itzzhashtag/ClickClock/Example - (My Build)/Top View.jpeg

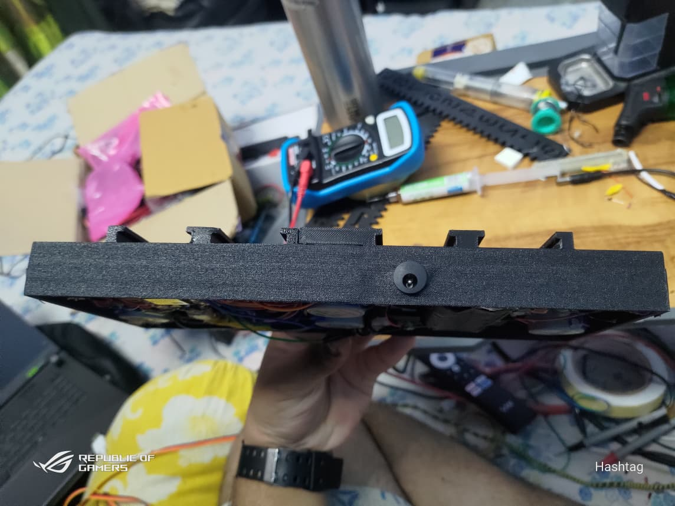
Example - (My Build)/Top View.jpeg
