itzzhashtag/ClickClock/Example - (My Build)/Back View 1.jpeg

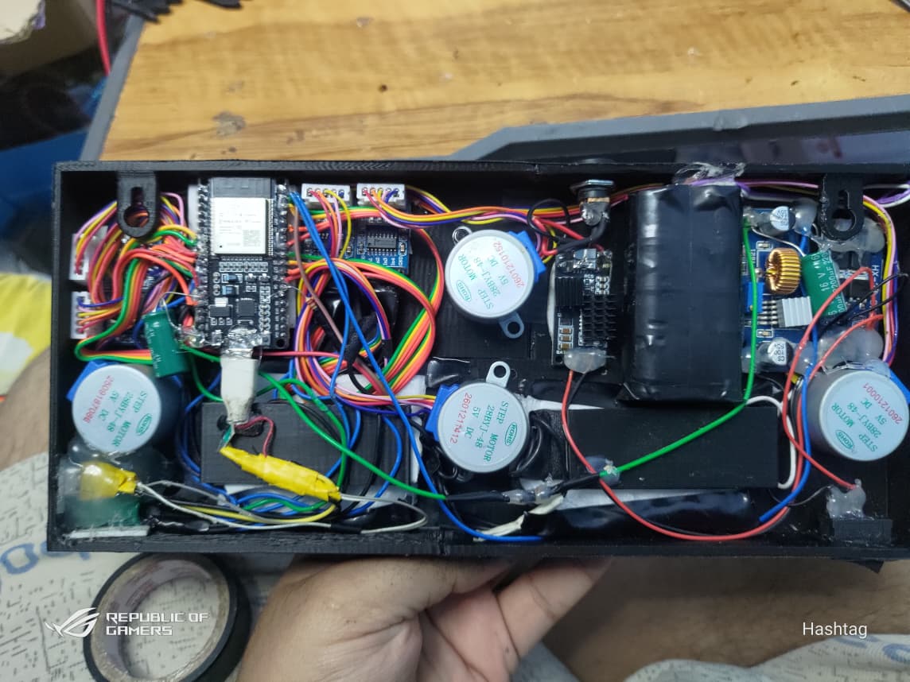
Example - (My Build)/Back View 1.jpeg
