itzzhashtag/ClickClock/STL files/FullDigit.stl

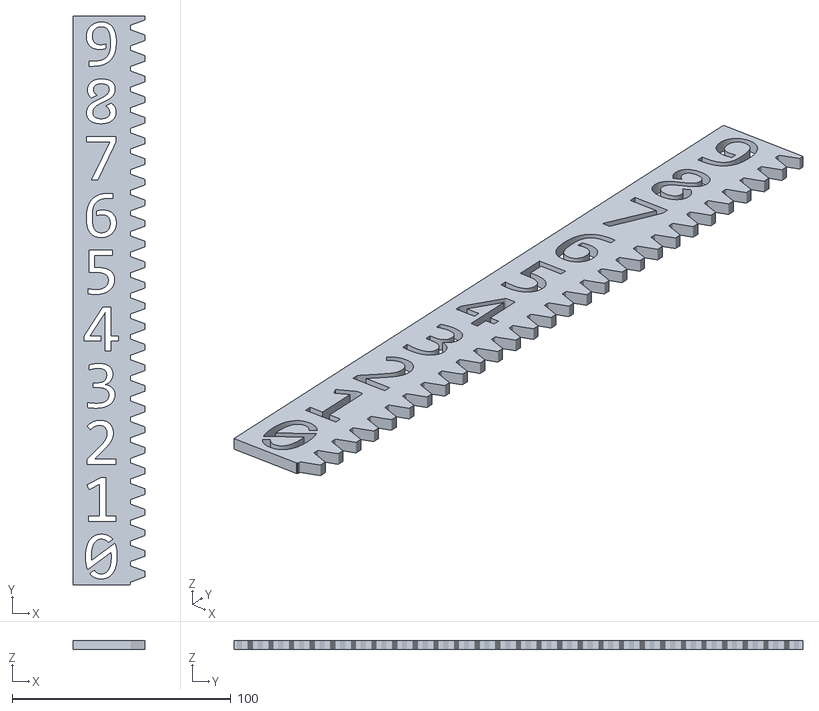
[picture p3: CAD file, 2026-03-24]
STL files/FullDigit.stl
33.0 x 260.0 x 4.00
