itzzhashtag/ClickClock/STL files/LightBrick.stl

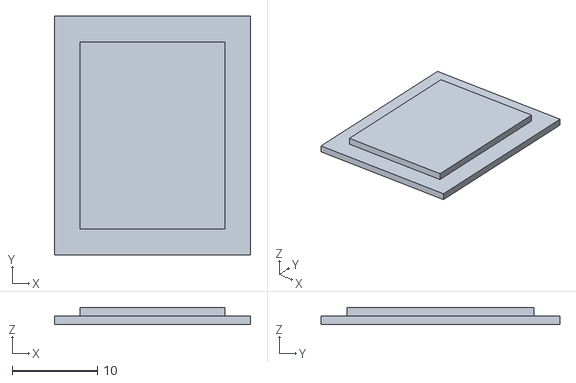
[picture p4: CAD file, 2026-03-24]
STL files/LightBrick.stl
23.0 x 28.0 x 2.00
