itzzhashtag/ClickClock/STL files/6Digit.stl

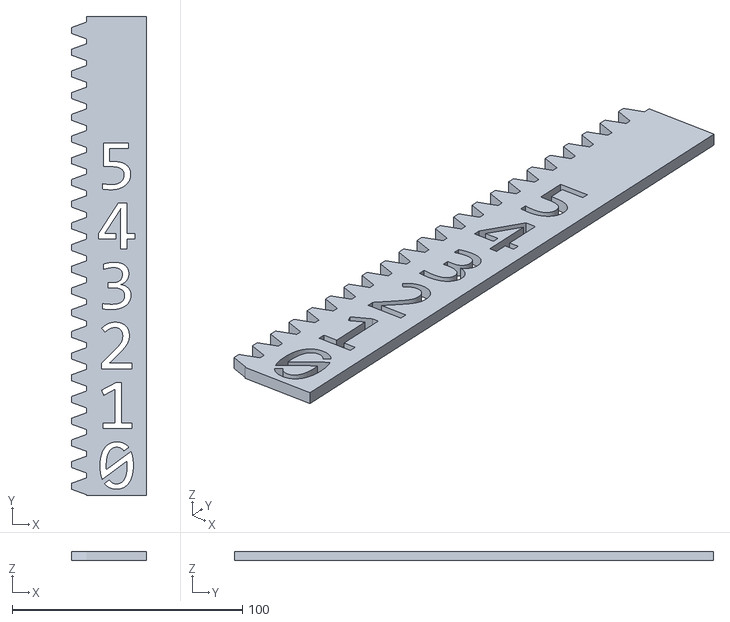
[picture p5: CAD file, 2026-03-24]
STL files/6Digit.stl
32.7 x 208.0 x 4.00
