itzzhashtag/ClickClock/STL files/BaseB.stl

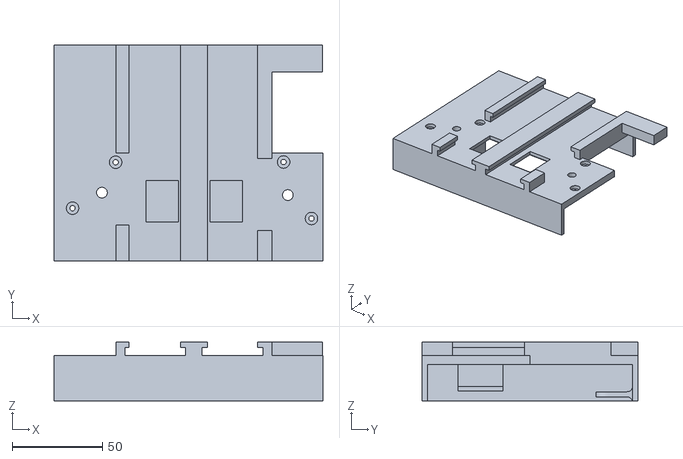
[picture p6: CAD file, 2026-03-24]
STL files/BaseB.stl
149.4 x 120.0 x 32.5
