itzzhashtag/ClickClock/STL files/3Digit.stl

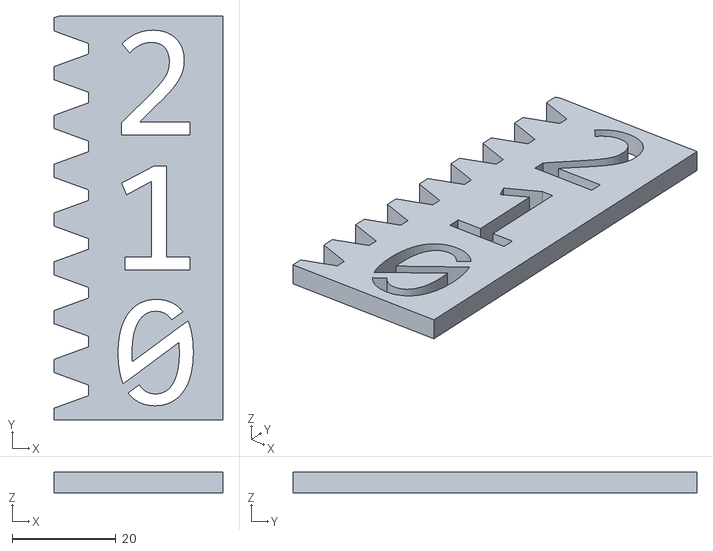
[picture p7: CAD file, 2026-03-24]
STL files/3Digit.stl
32.6 x 78.0 x 4.00
