itzzhashtag/ClickClock/STL files/Gear.stl

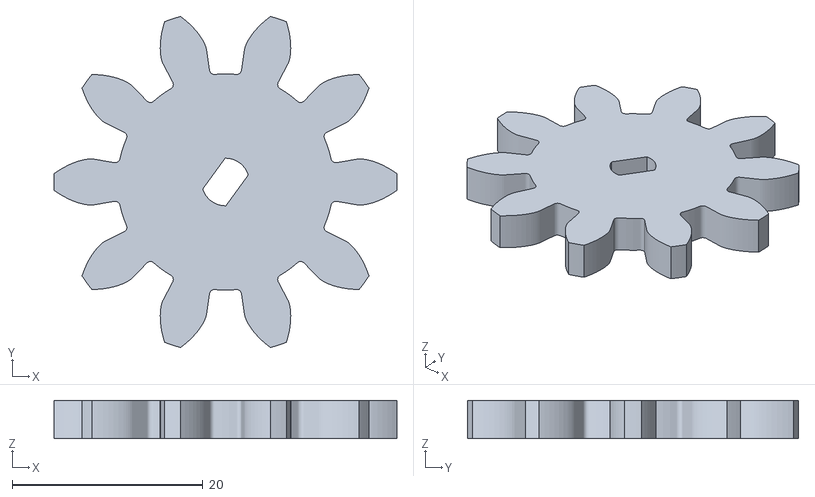
[picture p8: CAD file, 2026-03-24]
STL files/Gear.stl
36.0 x 34.7 x 4.00
