itzzhashtag/ClickClock/STL files/BaseA.stl

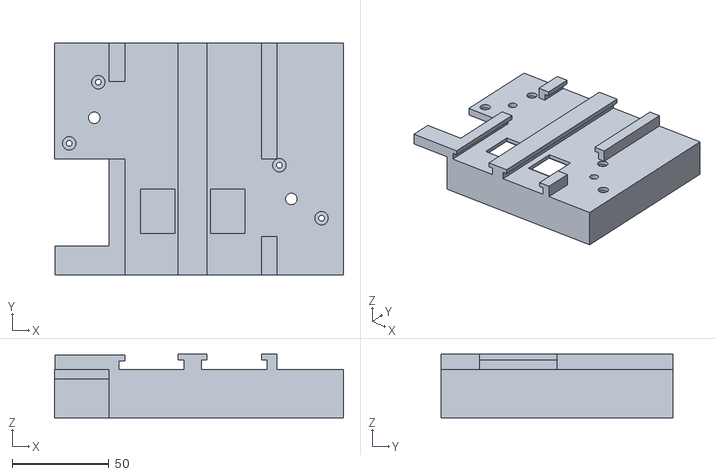
[picture p9: CAD file, 2026-03-24]
STL files/BaseA.stl
149.5 x 120.0 x 33.0
