itzzhashtag/ClickClock/Example - (My Build)/Back View 2.jpeg

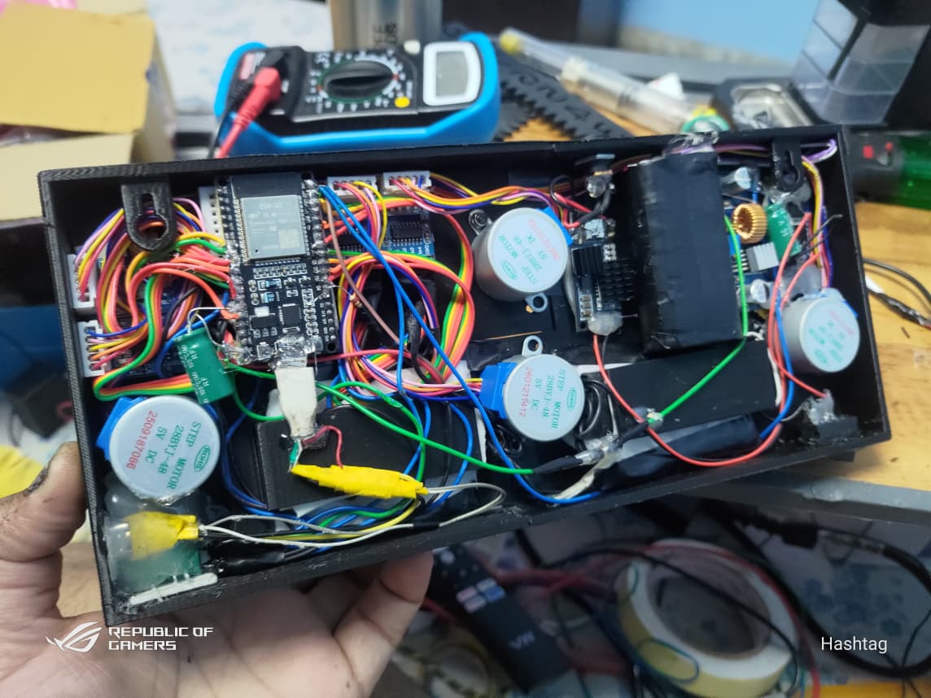
Example - (My Build)/Back View 2.jpeg
