itzzhashtag/ClickClock/Example - (My Build)/Bottom View.jpeg

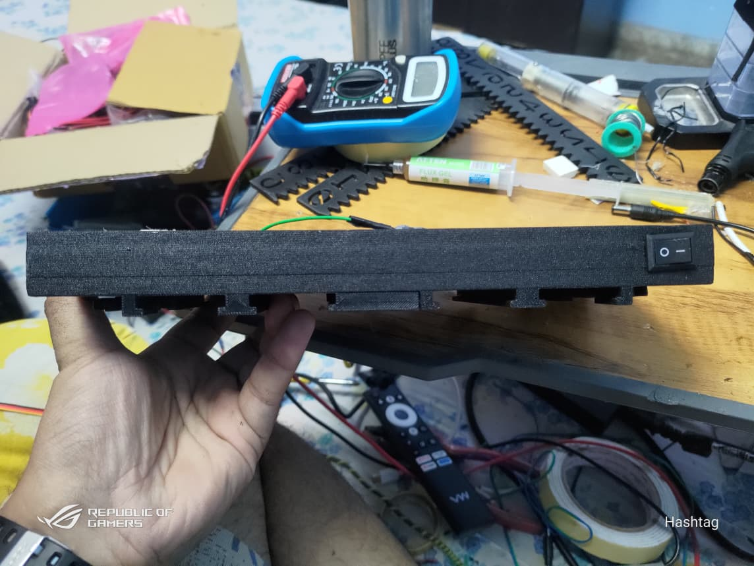
Example - (My Build)/Bottom View.jpeg
