itzzhashtag/ClickClock/Example - (My Build)/Front View.jpeg

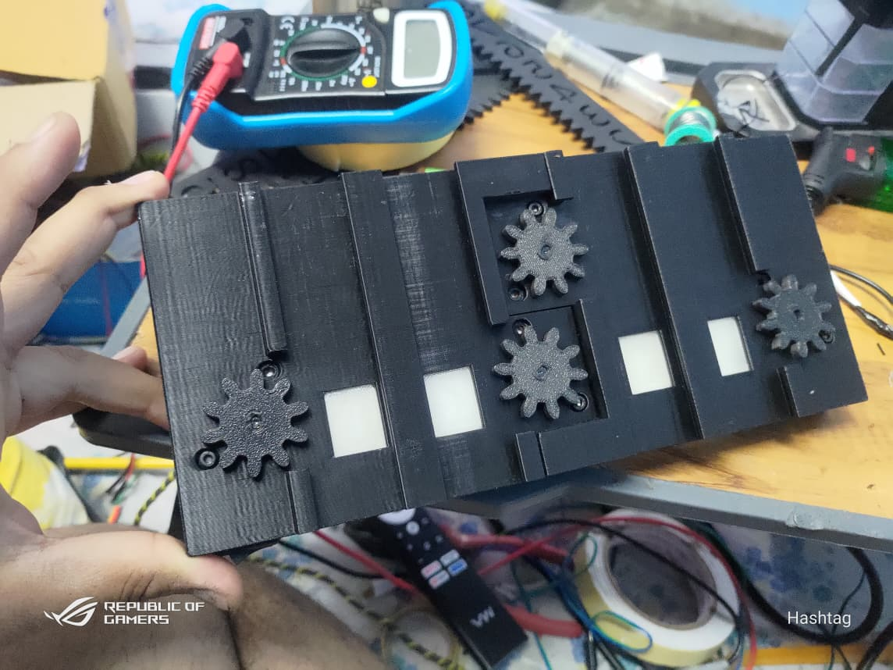
Example - (My Build)/Front View.jpeg
