itzzhashtag/ClickClock/Example - (My Build)/Left View.jpeg

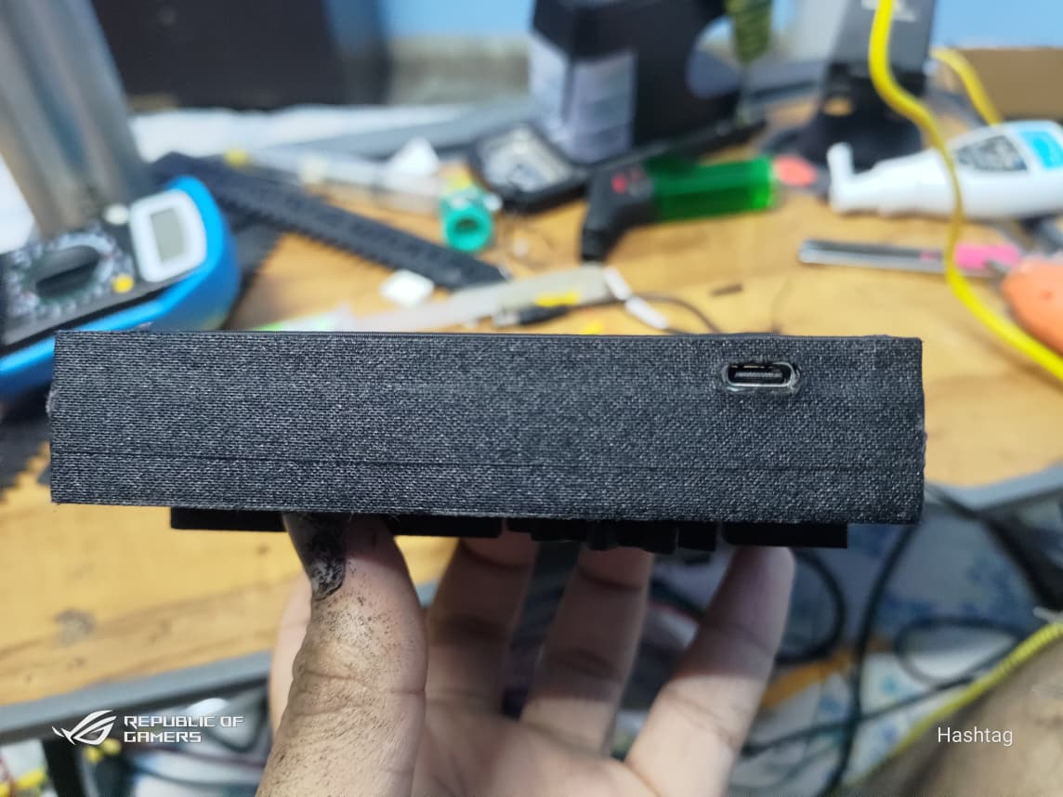
Example - (My Build)/Left View.jpeg
