itzzhashtag/ClickClock/ClickCock [Upload]-GitHub/Version v1.9/ClickClock_v1.9/ClickClock_v1.9.ino/ClickClock_v1.9.ino.ino

// ============================================================
//  _   _    _    ____  _   _ _____   _     ____ 
// | | | |  / \  / ___|| | | |_   _| / \   / ___|
// | |_| | / _ \ \___ \| |_| | | |  / _ \ | |  _ 
// |  _  |/ ___ \ ___) |  _  | | | / ___ \| |_| |
// |_| |_/_/   \_\____/|_| |_| |_|/_/   \_\\____|
//
//  Click Clock — ESP32 Stepper Digit Clock
//  HH:MM — 24hr Format — NTP Synced — IST (UTC+5:30)
//  H1: 0-2 | H2: 0-9 | M1: 0-5 | M2: 0-9
//  Wokwi Simulation - "https://wokwi.com/projects/459433718585621505"
// ============================================================


// ============================================================
// ----- Libraries -----
// ============================================================
#include <WiFi.h>               // ESP32 WiFi
#include "time.h"               // NTP time functions
#include <Stepper.h>            // Stepper motor control
#include <Adafruit_NeoPixel.h>  // WS2812 RGB LED strip
#include <Preferences.h>
Preferences prefs;

// ============================================================
// ----- WiFi Config -----
// ============================================================
const char* ssid = "your_ssid";           // Wifi SSID
const char* password = "ssid_password";   // Wifi Passcode

// Static IP config (optional — comment out if using DHCP)
IPAddress local_IP("Your_ESP32_IP");       // Static IP for ESP1 Set something nearby your IP
IPAddress gateway("Your_static_Ip");      // Routers IP - Wifi
IPAddress subnet(255, 255, 255, 0);     // Subnet mask
IPAddress primaryDNS(8, 8, 8, 8);       // Google primary DNS
IPAddress secondaryDNS(8, 8, 4, 4);     // Google secondary DNS


// ============================================================
// ----- NTP Time Config -----
// ============================================================
const char* ntpServer1 = "time.google.com";   // Primary NTP server
const char* ntpServer2 = "pool.ntp.org";      // Fallback NTP server
const char* ntpServer3 = "time.windows.com";  // Second fallback

const long gmtOffset_sec      = 19800;  // IST = UTC + 5:30 = 19800 seconds
const int  daylightOffset_sec = 0;      // India has no daylight saving


// ============================================================
// ----- Global Variables -----
// ============================================================
unsigned long lastSync = 0;                          // Timestamp of last NTP resync
const unsigned long syncInterval = 1UL * 59 * 1000; // Resync every 59 seconds

int hour, minute;       // Current hour and minute (assigned from NTP)
int h1, h2, m1, m2;    // Individual digits: HH:MM → h1 h2 : m1 m2

bool wifiSyncedFirstTime = false;  // True after first successful WiFi connect
bool timeSynced          = false;  // True after first successful NTP sync


// ============================================================
// ----- LED Strip Config -----
// ============================================================
const int LED_Port  = 4;   // GPIO pin connected to LED data line
const int ledCount  = 4;   // Number of LEDs in the strip
int       ledMode   = 0;   // Current LED mode (reserved for future use)
Adafruit_NeoPixel strip = Adafruit_NeoPixel(ledCount, LED_Port, NEO_GRB + NEO_KHZ800); // Initialise NeoPixel strip object

// ============================================================
// ----- ClockDigit Class -----
// Controls one stepper motor that drives one digit column
// Each digit position = STEPS_PER_DIGIT motor steps
// invert_direction: +1 or -1 — flip if motor spins wrong way
// ============================================================
class ClockDigit
{
  int8_t current_digit    = 0;
  int8_t invert_direction = 1;
  int    STEPS_PER_DIGIT;

  int pins[4];
  int stepIndex = 0;

  const int halfStep[8][4] = {
    {1,0,0,0}, {1,1,0,0},
    {0,1,0,0}, {0,1,1,0},
    {0,0,1,0}, {0,0,1,1},
    {0,0,0,1}, {1,0,0,1}
  };

  void _step(int dir)
  {
    stepIndex = (stepIndex + (dir > 0 ? 1 : 7)) % 8;
    for (int i = 0; i < 4; i++)
      digitalWrite(pins[i], halfStep[stepIndex][i]);
    delayMicroseconds(1200);
  }

  void _move(int steps)
  {
    int dir   = (steps > 0) ? invert_direction : -invert_direction;
    int count = abs(steps);
    for (int i = 0; i < count; i++) _step(dir);
    // release coils after move
    for (int i = 0; i < 4; i++) digitalWrite(pins[i], LOW);
  }

public:
  ClockDigit(int8_t dir, int spd, int p1, int p2, int p3, int p4)
    : invert_direction(dir), STEPS_PER_DIGIT(spd)
  {
    pins[0]=p1; pins[1]=p2; pins[2]=p3; pins[3]=p4;
    for (int i = 0; i < 4; i++) {
      pinMode(pins[i], OUTPUT);
      digitalWrite(pins[i], LOW);
    }
  }

  void set_to_digit(uint8_t digit)
  {
    int delta = digit - current_digit;
    if (delta != 0) {
      _move(STEPS_PER_DIGIT * delta);
      current_digit = digit;
    }
  }

  void force_zero()
  {
    _move(STEPS_PER_DIGIT * (-current_digit));
    current_digit = 0;
  }

  void boot_correct(int steps)
  {
    _move(steps);
  }
};

// ============================================================
// ----- Motor Objects -----
// ClockDigit(direction, IN1, IN2, IN3, IN4)
// direction: +1 = clockwise UP | -1 = anticlockwise UP
// ============================================================
//                  dir   spd  IN1 IN2 IN3 IN4
ClockDigit hour_ms  (-1, 1120,  18,  5, 17, 16);  // Hour tens   (0–2)
ClockDigit hour_ls  (1,  1120,  23, 22, 21, 19);  // Hour units  (0–9)
ClockDigit minute_ms(-1, 1120,  33, 32, 13, 12); // Min  tens   (0–5)
ClockDigit minute_ls(1,  1120,  14, 27, 26, 25);  // Min  units  (0–9)


// ============================================================
// ----- Flash TIme Reset -----
// Remembers Post-Reset Motor Position -> Resets to 00:00
// ============================================================
// ================= SAVE TIME TO FLASH =================

// Stores current time (HH:MM) into ESP32 flash memory
void saveTimeToFlash(int hh, int mm)
{
  prefs.begin("clock", false);   // Open namespace "clock" (write mode)

  int packed = hh * 100 + mm;    // Convert HH:MM → single int (e.g. 11:22 → 1122)
  prefs.putInt("time", packed);  // Save value with key "time"

  prefs.end();                   // Close preferences (important)

  Serial.printf("💾 Saved Time: %02d:%02d\n", hh, mm);  // Debug print
}

// ================= LOAD TIME FROM FLASH =================
// Reads last saved time from flash memory
int loadTimeFromFlash()
{
  prefs.begin("clock", true);    // Open namespace "clock" (read-only)

  int val = prefs.getInt("time", 0);  // Read "time", default = 0 if not found

  prefs.end();                   // Close preferences

  Serial.printf("📂 Loaded Time: %04d\n", val);  // Debug print

  return val;                    // Return stored value (HHMM format)
}

// ================= RECOVER TO ZERO =================
// Moves clock backwards from last saved position → 00:00
void recoverToZero()
{
  int saved = loadTimeFromFlash();   // Get last saved time

  // If nothing saved → skip recovery
  if (saved == 0) {
    Serial.println("🟢 No previous position — skipping recovery");
    return;
  }

  // Split HHMM → HH and MM
  int sh = saved / 100;   // Hours
  int sm = saved % 100;   // Minutes

  // Split into individual digits
  int sh1 = (sh / 10) % 3;  // Hour tens (0–2)
  int sh2 = sh % 10;        // Hour units (0–9)
  int sm1 = (sm / 10) % 6;  // Minute tens (0–5)
  int sm2 = sm % 10;        // Minute units (0–9)

  Serial.printf("🔁 Reverse from %02d:%02d → 00:00\n", sh, sm);

  // Move each motor BACKWARD to zero (no forward correction)
  hour_ms.boot_correct(-sh1 * 1120);     // Reverse H1
  hour_ls.boot_correct(-sh2 * 1120);     // Reverse H2
  minute_ms.boot_correct(-sm1 * 1120);   // Reverse M1
  minute_ls.boot_correct(-sm2 * 1120);   // Reverse M2

  delay(500);  // Small pause for stability

  // Force internal digit state to 0 (sync software with hardware)
  hour_ms.force_zero();
  hour_ls.force_zero();
  minute_ms.force_zero();
  minute_ls.force_zero();

  // Clear saved time (so it doesn't repeat on next boot)
  prefs.begin("clock", false);
  prefs.putInt("time", 0);
  prefs.end();

  Serial.println("✅ Recovery done");  // Debug print
}


// ============================================================
// ----- Motor Work -----
// Sends current h1 h2 m1 m2 digit values to each motor
// Motors move one at a time (Stepper library is blocking)
// ============================================================
void motorWork()
{
  Serial.println("⚙️  Moving Motors...");
  hour_ms.set_to_digit(h1);    // Move H1 to hour tens digit
  hour_ls.set_to_digit(h2);    // Move H2 to hour units digit
  minute_ms.set_to_digit(m1);  // Move M1 to minute tens digit
  minute_ls.set_to_digit(m2);  // Move M2 to minute units digit
  Serial.println("✅ Movement Done\n");
}


// ============================================================
// ----- LED Color Palette -----
// Returns a 32-bit GRB color value by index number
// ============================================================
uint32_t getColor(int flag)
{
  switch (flag)
  {
    case  0: return strip.Color(255, 255, 255);  // White
    case  1: return strip.Color(255,   0,   0);  // Red
    case  2: return strip.Color(  0, 255,   0);  // Green
    case  3: return strip.Color(  0,   0, 255);  // Blue
    case  4: return strip.Color(255, 165,   0);  // Orange
    case  5: return strip.Color(255, 255,   0);  // Yellow
    case  6: return strip.Color(  0, 255, 255);  // Cyan
    case  7: return strip.Color(255,  20, 147);  // Pink
    case  8: return strip.Color(128,   0, 128);  // Purple
    case  9: return strip.Color(  0, 128, 255);  // Aqua
    case 10: return strip.Color(255,  50,  50);  // Soft Red
    case 11: return strip.Color(255, 255,  50);  // Soft Yellow
    default: return strip.Color(255, 255, 255);  // Default White
  }
}


// ============================================================
// ----- LED Mode Controller -----
// Sets all 4 LEDs to a preset color pattern by mode number
//
//  0 = White (normal / idle)
//  1 = Cyan
//  2 = Orange
//  3 = Red        ← WiFi error indicator
//  4 = RGBY       ← Startup phase 1
//  5 = Mixed      ← Startup phase 2
//  6 = Soft Red   ← WiFi warning (offline but running)
//  7 = Purple     ← Boot indicator
//  8 = Soft Yellow ← NTP error indicator
// ============================================================
void ledTask(int Mode_Select)
{
  switch (Mode_Select)
  {
    case 1:  // Cyan — reserved
      for (int i = 0; i < 4; i++) strip.setPixelColor(i, getColor(6));
      break;

    case 2:  // Orange — NTP failed but continuing
      for (int i = 0; i < 4; i++) strip.setPixelColor(i, getColor(4));
      break;

    case 3:  // Red — WiFi connection error
      for (int i = 0; i < 4; i++) strip.setPixelColor(i, getColor(1));
      break;

    case 4:  // Red/Green/Blue/Yellow — startup phase 1 (going to max)
      strip.setPixelColor(0, getColor(1));  // Red
      strip.setPixelColor(1, getColor(2));  // Green
      strip.setPixelColor(2, getColor(3));  // Blue
      strip.setPixelColor(3, getColor(5));  // Yellow
      break;

    case 5:  // Orange/Pink/Aqua/SoftRed — startup phase 2 (returning to zero)
      strip.setPixelColor(0, getColor(4));   // Orange
      strip.setPixelColor(1, getColor(7));   // Pink
      strip.setPixelColor(2, getColor(9));   // Aqua
      strip.setPixelColor(3, getColor(10));  // Soft Red
      break;

    case 6:  // Soft Red — no WiFi warning (clock still running from RTC)
      for (int i = 0; i < 4; i++) strip.setPixelColor(i, getColor(10));
      break;

    case 7:  // Purple — boot sequence running
      for (int i = 0; i < 4; i++) strip.setPixelColor(i, getColor(8));
      break;

    case 8:  // Soft Yellow — NTP unreachable, retrying
      for (int i = 0; i < 4; i++) strip.setPixelColor(i, getColor(11));
      break;

    case 0:  // White — normal idle state
    default:
      for (int i = 0; i < 4; i++) strip.setPixelColor(i, getColor(0));
      break;
  }
  strip.show();  // Push color data to physical LEDs
}


// ============================================================
// ----- Startup Animation -----
// Runs once on boot to verify all motors are working
// Phase 1: all digits rise to their maximum position
// Phase 2: all digits return back down to zero
// ============================================================
void startup()
{
  Serial.println("🎬 Startup animation starting...");

  // Phase 1 — rise to max (motors go UP one by one)
  ledTask(4);                   // LED: Red/Green/Blue/Yellow
  hour_ms.set_to_digit(2);      // H1 max = 2
  hour_ls.set_to_digit(9);      // H2 max = 9
  minute_ms.set_to_digit(5);    // M1 max = 5
  minute_ls.set_to_digit(9);    // M2 max = 9
  delay(1000);                  // Brief pause at top

  // Phase 2 — return to zero (motors go DOWN one by one)
  ledTask(5);                   // LED: Orange/Pink/Aqua/SoftRed
  hour_ms.force_zero();         // H1 → 0
  hour_ls.force_zero();         // H2 → 0
  minute_ms.force_zero();       // M1 → 0
  minute_ls.force_zero();       // M2 → 0
  delay(500);                   // Settle before clock starts

  Serial.println("✅ Startup done.");
  ledTask(0);                   // LED: back to white
}


// ============================================================
// ----- WiFi Connect -----
// Attempts WiFi connection with a 5 second timeout
// Sets LED red on failure, white on success
// ============================================================
void wifi_connect()
{
  Serial.println("🔄 Connecting to WiFi...");
  WiFi.mode(WIFI_STA);                     // Station mode (client)
  //WiFi.config(local_IP, gateway, subnet, primaryDNS, secondaryDNS);  //Configuration of WIfi 
  WiFi.begin(ssid, password);

  unsigned long startAttemptTime = millis();
  const unsigned long timeout    = 5000;   // Give up after 5 seconds

  // Poll until connected or timed out
  while (WiFi.status() != WL_CONNECTED && millis() - startAttemptTime < timeout)
  {
    delay(200);
    Serial.print(".");
  }

  if (WiFi.status() == WL_CONNECTED)
  {
    Serial.println("\n✅ WiFi Connected!");
    ledTask(0);  // White — all good
  }
  else
  {
    Serial.println("\n❌ WiFi Failed (Continuing Offline)");
    ledTask(1);  // Red — connection failed
  }
}


// ============================================================
// ----- Time → Digits -----
// Reads current time from ESP32 internal RTC (set by NTP)
// Splits HH:MM into four individual digits h1 h2 m1 m2
// Also triggers periodic NTP resync every syncInterval ms
// ============================================================
void timeSet()
{
  struct tm timeinfo;

  // Read time from ESP32 internal RTC
  if (!getLocalTime(&timeinfo))
  {
    Serial.println("❌ Failed to read internal time");
    ledTask(3);  // Red — RTC read error
    return;
  }

  // Assign to globals (no `int` here — already declared globally)
  hour   = timeinfo.tm_hour;
  minute = timeinfo.tm_min;

  // Split into individual digits
  h1 = (hour   / 10) % 3;  // Hour   tens  — valid range 0–2
  h2 =  hour   % 10;       // Hour   units — valid range 0–9
  m1 = (minute / 10) % 6;  // Minute tens  — valid range 0–5
  m2 =  minute % 10;       // Minute units — valid range 0–9

  // Serial debug output
  Serial.println("=========================");
  Serial.printf( "🕒 Time: %02d:%02d\n", hour, minute);
  Serial.print(  "   H1 (hour tens)    : "); Serial.println(h1);
  Serial.print(  "   H2 (hour units)   : "); Serial.println(h2);
  Serial.print(  "   M1 (minute tens)  : "); Serial.println(m1);
  Serial.print(  "   M2 (minute units) : "); Serial.println(m2);
  Serial.printf( "   Digits → %d%d:%d%d\n", h1, h2, m1, m2);
  Serial.println("=========================");

  // Periodic NTP resync — triggered every syncInterval milliseconds
  if (millis() - lastSync > syncInterval)
  {
    Serial.println("🔄 Periodic NTP Resync...");
    syncTimeNTP();        // Attempt resync (LED handled inside)
    lastSync = millis();  // Reset resync timer
  }
}


// ============================================================
// ----- NTP Sync -----
// Handles three cases:
//   1. First boot — blocks until WiFi connects
//   2. First boot — blocks until NTP responds
//   3. Normal operation — resync if WiFi available, warn if not
// ============================================================
void syncTimeNTP()
{
  // ----- Case 1: First time WiFi -----
  // Keeps retrying forever until connected on first boot
  if (!wifiSyncedFirstTime)
  {
    Serial.println("⚠️  First boot — waiting for WiFi...");
    while (true)
    {
      wifi_connect();

      if (WiFi.status() == WL_CONNECTED)
      {
        Serial.println("✅ First WiFi connection successful!");
        wifiSyncedFirstTime = true;  // Never enter this block again
        ledTask(0);                  // White — WiFi OK
        break;
      }

      Serial.println("❌ WiFi not found — retrying in 1s...");
      ledTask(3);      // Red — WiFi error
      delay(1000);
    }
  }

  // ----- Case 2: First time NTP -----
  // Keeps retrying forever until time is received on first boot
  if (!timeSynced)
  {
    Serial.println("⚠️  First boot — waiting for NTP...");
    while (true)
    {
      configTime(gmtOffset_sec, daylightOffset_sec, ntpServer1, ntpServer2, ntpServer3);
      struct tm timeinfo;

      if (getLocalTime(&timeinfo))
      {
        Serial.println("✅ First NTP sync successful!");
        
        timeSynced = true;  // Never enter this block again
        ledTask(0);         // White — NTP OK
        break;
      }

      Serial.println("❌ NTP not reachable — retrying in 1s...");
      ledTask(8);    // Soft Yellow — NTP error
      delay(1000);
    }
  }

  // ----- Case 3: Normal periodic resync -----
  // If WiFi is gone, warn and try reconnecting — but don't block
  if (WiFi.status() != WL_CONNECTED)
  {
    Serial.println("❌ No WiFi — skipping resync (clock still running)");
    ledTask(6);      // Soft Red — offline warning
    wifi_connect();  // Try reconnecting (non-blocking, 5s timeout)
    return;
  }

  // WiFi is up — request fresh time from NTP
  configTime(gmtOffset_sec, daylightOffset_sec, ntpServer1, ntpServer2, ntpServer3);
  struct tm timeinfo;

  if (getLocalTime(&timeinfo))
  {
    Serial.println("✅ NTP resync successful");
    ledTask(0);  // White — all good
  }
  else
  {
    Serial.println("❌ NTP resync failed — continuing from internal RTC");
    ledTask(2);  // Orange — NTP failed but clock still running
  }
}


// ============================================================
// ----- Setup -----
// Runs once on power-on or reset
// ============================================================
int lastMinute = -1;  // Tracks last minute to detect changes

void setup()
{
  Serial.begin(115200);   // Start serial monitor at 115200 baud
  //Wire.begin(15, 2);  // SDA=15, SCL=2 — DS3231
  
  strip.begin();          // Initialise LED strip (required before any LED calls)
  strip.show();           // Push blank frame — ensures all LEDs start OFF
  ledTask(7);             // Purple — boot in progress
  minute_ls.boot_correct(2);  // Fix Drift in M2 -> Hrs 00:0*
  minute_ms.boot_correct(2);  // Fix Drift in M1 -> Hrs 00:*0
  hour_ls.boot_correct(2);    // Fix Drift in H2 -> Hrs 0*:00
  hour_ms.boot_correct(2);    // Fix Drift in H1 -> Hrs *0:00

  delay(500);             // Brief pause so purple is visible
  wifi_connect();         // Connect to WiFi (5s timeout, non-blocking)
  syncTimeNTP();          // Sync time from NTP (blocks until first sync)
  recoverToZero();   // et back to Zero in case System was Restarted whilw working
  startup();         // THEN normal animation -> Run motor + LED startup animation
}


// ============================================================
// ----- Loop -----
// Runs continuously — checks if minute has changed
// Only updates motors once per minute to save wear
// ============================================================
void loop()
{
  struct tm timeinfo;

  // If RTC is unavailable, skip this iteration
  if (!getLocalTime(&timeinfo)) return;

  // Check if the minute has changed since last update
  if (timeinfo.tm_min != lastMinute)
  {
    lastMinute = timeinfo.tm_min;              // Store new minute
    Serial.println("⏱  Minute changed → updating clock");
    timeSet();    // Read time, split digits, trigger resync if due
    motorWork();  // Move all 4 motors to new digit positions
     
    saveTimeToFlash(hour, minute);  // ✅ SAVE HERE
  }
}

// ============================================================
// ----- The End -----
// ============================================================
